zainahm3d/saleae-current-sensor/components/AD8422BRMZ-RL/AD8422BRMZ-RL.step

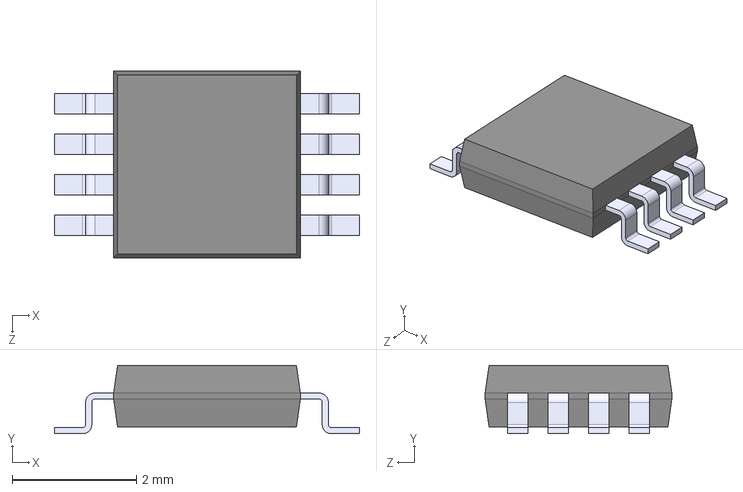
[picture p1: CAD file, 2022-12-26]
components/AD8422BRMZ-RL/AD8422BRMZ-RL.step
4.90 x 1.10 x 3.00 mm
