zainahm3d/saleae-current-sensor/components/LT3461ES6_TRPBF/LT3461ES6_TRPBF.step

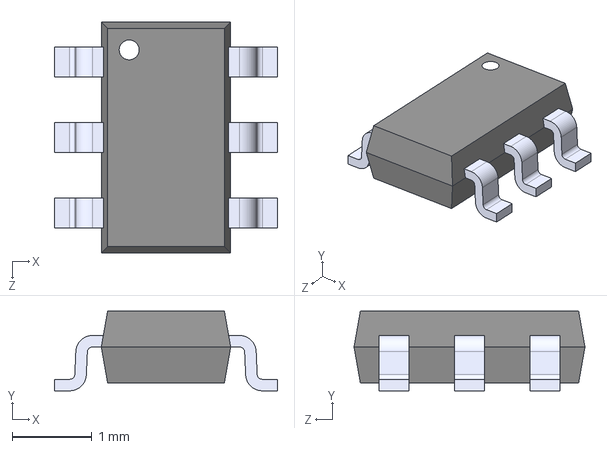
[picture p2: CAD file, 2022-12-05]
components/LT3461ES6_TRPBF/LT3461ES6_TRPBF.step
2.80 x 1.00 x 2.90 mm
