zainahm3d/saleae-current-sensor/components/TES_1-0523/TES_1-0523.step

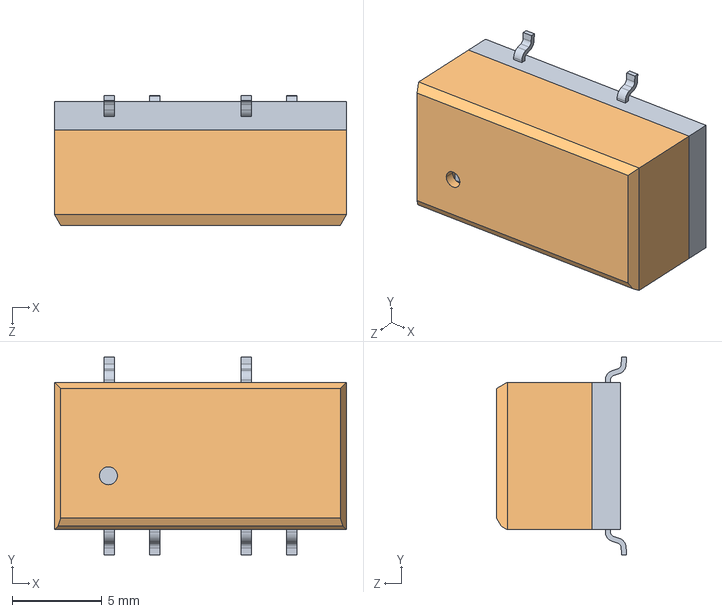
[picture p3: CAD file, 2022-12-05]
components/TES_1-0523/TES_1-0523.step
16.2 x 11.0 x 7.23 mm
base
cover
