zainahm3d/saleae-current-sensor/components/TSM-104-02-T-DH/TSM-104-02-T-DH.step

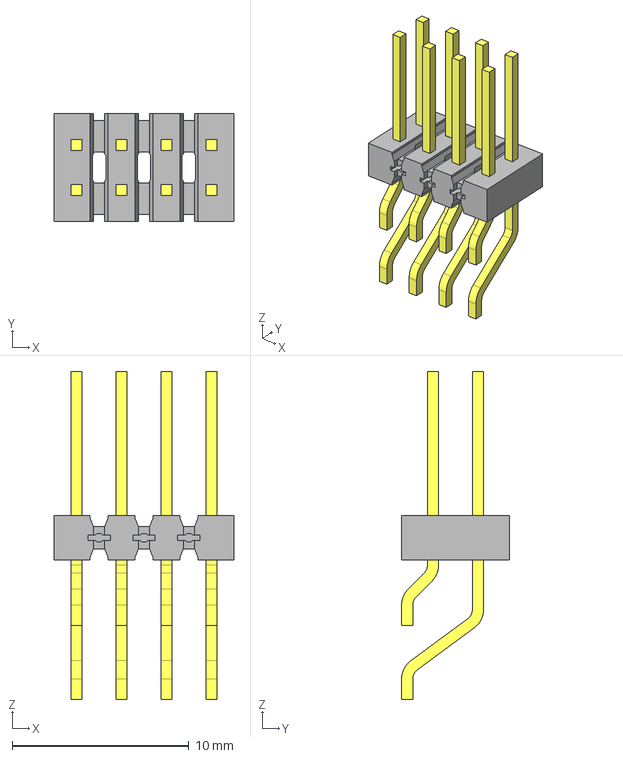
[picture p4: CAD file, 2022-12-30]
components/TSM-104-02-T-DH/TSM-104-02-T-DH.step
10.2 x 6.10 x 18.5 mm
T-1S6-09(-02-4-DH)
TSM-104-02-DH_body
