zainahm3d/saleae-current-sensor/components/USB4505-03-0-A_REVA/USB4505-03-0-A_REVA.step

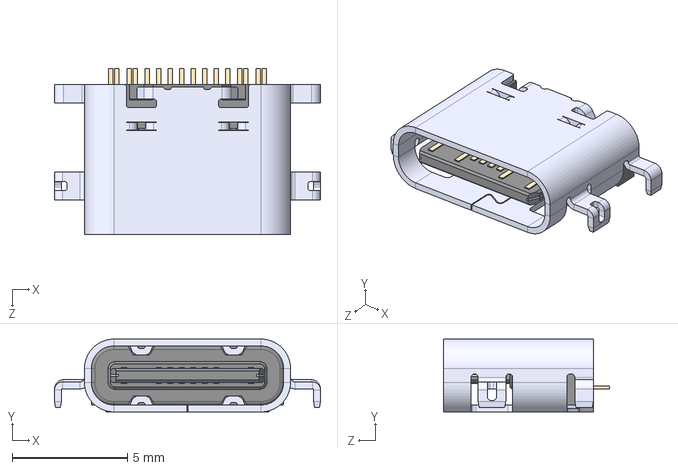
[picture p5: CAD file, 2022-12-05]
components/USB4505-03-0-A_REVA/USB4505-03-0-A_REVA.step
11.5 x 3.16 x 7.20 mm
