zainahm3d/saleae-current-sensor/saleae_current_sensor.kicad_pcb

## KiCad design saleae_current_sensor.kicad_pcb (2023-07-23)

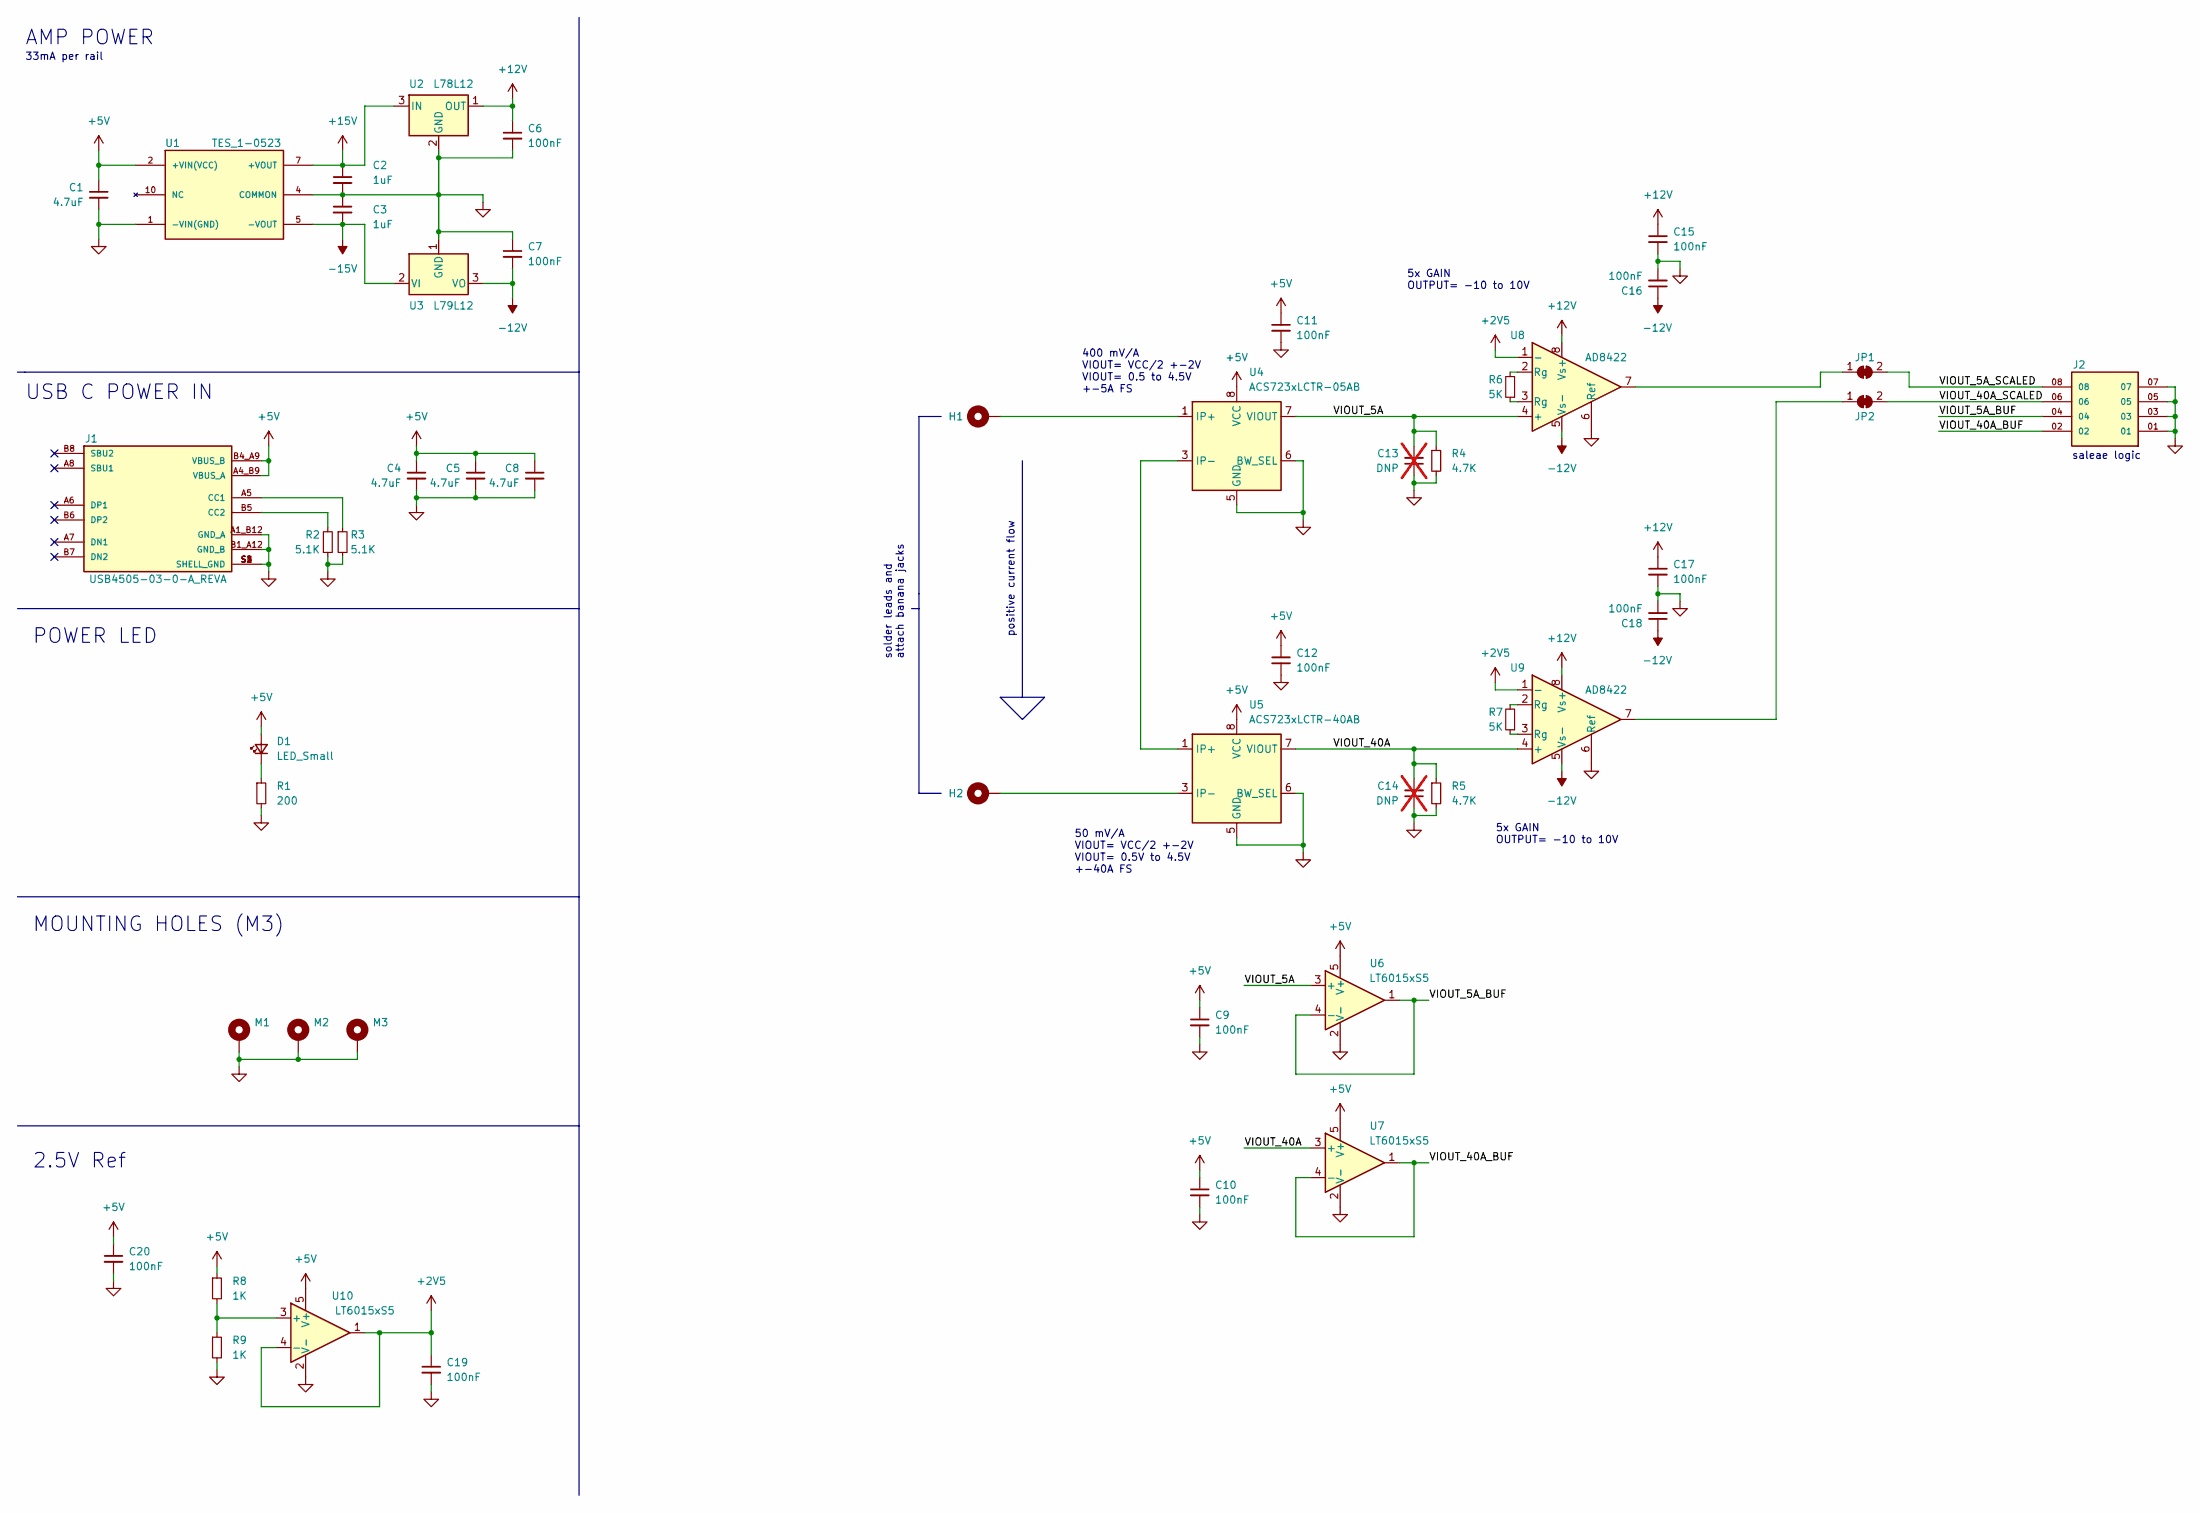
[picture p6: schematic saleae_current_sensor.kicad_sch, Saleae Current Sensor]

Parts:
C1, C4, C5, C8: 4.7uF; C_1206_3216Metric
C2, C3: 1uF; C_1206_3216Metric
C6, C7, C9, C10, C11, C12, C15, C16, C17, C18, C19, C20: 100nF; C_0603_1608Metric
C13, C14: DNP; C_0603_1608Metric; not fitted
D1: LED_Small; LED_1206_3216Metric
H1: IP; MountingHole_2.7mm_M2.5_ISO7380_Pad_TopBottom
H2: IN; MountingHole_2.7mm_M2.5_ISO7380_Pad_TopBottom
J1: USB4505-03-0-A_REVA; GCT_USB4505-03-0-A_REVA; PARTREV A
J2: TSM-104-02-T-DH; SAMTEC_TSM-104-02-T-DH; PARTREV R
JP1, JP2: SolderJumper_2_Bridged; SolderJumper-2_P1.3mm_Bridged2Bar_Pad1.0x1.5mm
M1, M2, M3: MountingHole_Pad; MountingHole_3.2mm_M3_ISO7380_Pad_TopBottom
R1: 200; R_0603_1608Metric
R2, R3: 5.1K; R_0603_1608Metric
R4, R5: 4.7K; R_0603_1608Metric
R6, R7: 5K; R_0603_1608Metric
R8, R9: 1K; R_0603_1608Metric
U1: TES_1-0523; CONV_TES_1-0523; PARTREV June 23, 2020
U2: L78L12; SOT-89-3
U3: L79L12; SOT-89-3
U4: ACS723xLCTR-05AB; SOIC-8_3.9x4.9mm_P1.27mm
U5: ACS723xLCTR-40AB; SOIC-8_3.9x4.9mm_P1.27mm
U6, U7, U10: LT6015xS5; SOT-23-5
U8, U9: AD8422; SOP65P490X110-8N

Connections:
+2V5: C19.1, U8.1 (-), U9.1 (-), U10.1, U10.4 (-)
+5V: C1.1, C4.1, C5.1, C8.1, C9.1, C10.1, C11.1, C12.1, C20.1, D1.2 (A), J1.A4_B9 (VBUS_A), J1.B4_A9 (VBUS_B), R8.1, U1.2 (+VIN(VCC)), U4.8 (VCC), U5.8 (VCC), U6.5 (V+), U7.5 (V+), U10.5 (V+)
+12V: C6.1, C15.1, C17.1, U2.1 (OUT), U8.8 (Vs+), U9.8 (Vs+)
+15V: C2.1, U1.7 (+VOUT), U2.3 (IN)
-12V: C7.2, C16.1, C18.1, U3.3 (VO), U8.5 (Vs-), U9.5 (Vs-)
-15V: C3.2, U1.5 (-VOUT), U3.2 (VI)
/VIOUT_5A: C13.2, R4.1, U4.7 (VIOUT), U6.3 (+), U8.4 (+)
/VIOUT_5A_BUF: J2.04, U6.1, U6.4 (-)
/VIOUT_5A_SCALED: J2.08, JP1.2 (B)
/VIOUT_40A: C14.2, R5.1, U5.7 (VIOUT), U7.3 (+), U9.4 (+)
/VIOUT_40A_BUF: J2.02, U7.1, U7.4 (-)
/VIOUT_40A_SCALED: J2.06, JP2.2 (B)
GND: C1.2, C2.2, C3.1, C4.2, C5.2, C6.2, C7.1, C8.2, C9.2, C10.2, C11.2, C12.2, C13.1, C14.1, C15.2, C16.2, C17.2, C18.2, C19.2, C20.2, J1.A1_B12 (GND_A), J1.B1_A12 (GND_B), J1.S1 (SHELL_GND), J1.S2 (SHELL_GND), J1.S3 (SHELL_GND), J1.S4 (SHELL_GND), J2.01, J2.03, J2.05, J2.07, M1.1, M2.1, M3.1, R1.2, R2.1, R3.2, R4.2, R5.2, R9.2, U1.1 (-VIN(GND)), U1.4 (COMMON), U2.2 (GND), U3.1 (GND), U4.5 (GND), U4.6 (BW_SEL), U5.5 (GND), U5.6 (BW_SEL), U6.2 (V-), U7.2 (V-), U8.6 (Ref), U9.6 (Ref), U10.2 (V-)
unnamed: D1.1 (K), R1.1
unnamed: H1.1, U4.1 (IP+), U4.2 (IP+)
unnamed: H2.1, U5.3 (IP-), U5.4 (IP-)
unnamed: J1.A5 (CC1), R3.1
unnamed: J1.B5 (CC2), R2.2
unnamed: JP1.1 (A), U8.7
unnamed: JP2.1 (A), U9.7
unnamed: R6.1, U8.3 (Rg)
unnamed: R6.2, U8.2 (Rg)
unnamed: R7.1, U9.3 (Rg)
unnamed: R7.2, U9.2 (Rg)
unnamed: U4.3 (IP-), U4.4 (IP-), U5.1 (IP+), U5.2 (IP+)
unnamed: R8.2, R9.1, U10.3 (+)

Notes on the sheet:
50 mV/A VIOUT= VCC/2 +-2V VIOUT= 0.5V to 4.5V +-40A FS
solder leads and attach banana jacks
positive current flow
saleae logic
2.5V Ref
AMP POWER
POWER LED
MOUNTING HOLES (M3)
5x GAIN OUTPUT= -10 to 10V
33mA per rail
USB C POWER IN
400 mV/A VIOUT= VCC/2 +-2V VIOUT= 0.5 to 4.5V +-5A FS

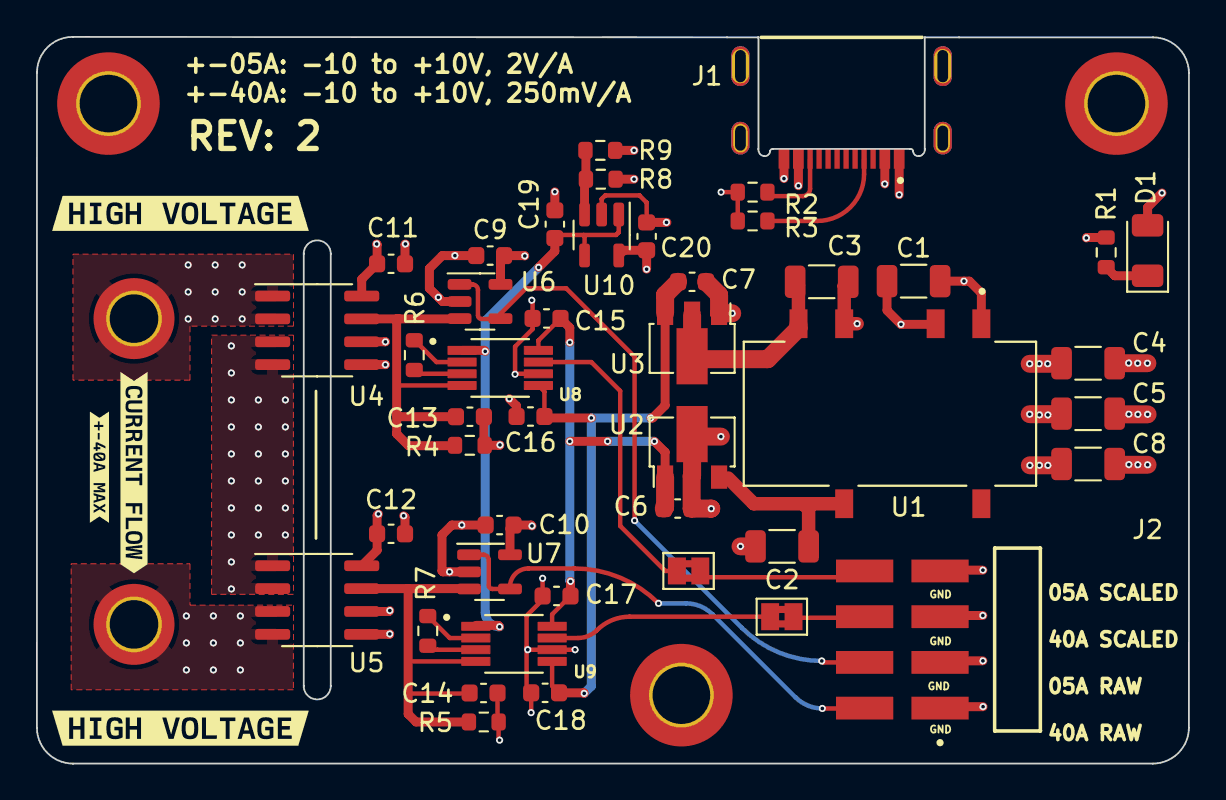
[picture p7: board saleae_current_sensor.kicad_pcb from above]

Board: 4 copper layers, 64.0 x 40.4 mm, 54 parts (1 on the bottom side), 26 nets.

Other parts of the board:
kibuzzard-64A2F4F2: G***; kibuzzard-64A2F4F2
kibuzzard-64A2F4F7: G***; kibuzzard-64A2F4F7
kibuzzard-64A2F491: G***; kibuzzard-64A2F491
kibuzzard-64A244C5: G***; kibuzzard-64A244C5
kibuzzard-64A24575: G***; kibuzzard-64A24575
