zainahm3d/saleae-current-sensor/(commit log)

2022-12-05 [WIP] Initial commit
    [LT3461ES6_TRPBF.step, TES_1-0523.step, USB4505-03-0-A_REVA.step, power.kicad_sch, saleae_current_sensor.kicad_pcb, saleae_current_sensor.kicad_sch]
2022-12-26 Add buffers to raw signals Add connections for main power lines Annotate all components Assign all footprints
    [AD8422BRMZ-RL.step, FTSH-104-01-SM-D-RA.step, saleae_current_sensor.kicad_pcb, saleae_current_sensor.kicad_sch]
2022-12-30 Layout complete
    [FTSH-104-01-SM-D-RA.step, TSM-104-02-T-DH.step, saleae_current_sensor.kicad_pcb, saleae_current_sensor.kicad_sch]
2023-02-27 update to KiCAD 7
    [saleae_current_sensor.kicad_pcb, saleae_current_sensor.kicad_sch]
2023-06-24 Export outputs via GitHub Actions w/ KiCad CLI
    [power.kicad_sch, saleae_current_sensor.kicad_pcb]
2023-07-04 Misc updates kibuzzard lock in mounting holes/connectors change dielectric thickness for total 1.6mm stackup CI updates
    [saleae_current_sensor.kicad_pcb, saleae_current_sensor.kicad_sch]
2023-07-04 Final changes for JLCPCB order
    [saleae_current_sensor.kicad_pcb, saleae_current_sensor.kicad_sch]
2023-07-07 Route a gap between LV and HV sides of current sensors
    [saleae_current_sensor.kicad_pcb]
2023-07-23 Add 2V5 voltage reference :( and reduce LED resistor
    [saleae_current_sensor.kicad_pcb, saleae_current_sensor.kicad_sch]
