zainahm3d/saleae-current-sensor/(notices)

Notices in the files:
components/TSM-104-02-T-DH/TSM-104-02-T-DH.step:
author */ ('License CC BY-ND 4.0'),
